FPGA-Computer/Linear-Power-Supply/README.md

These is my entry for the 1k Challenge for 2016
This is a linear power supply that is controlled digitally by a ATMega8.

The hardware design is licensed under a Creative Commons BY 4.0 International License.
The firmware is licensed under GPL 3.0

Schematic is EagleCAD file and firmware is for Atmel Studio 7.0.

The full detail of these licenses:

http://creativecommons.org/licenses/by/4.0/

http://www.gnu.org/licenses/gpl-3.0.en.html

Project page:
https://hw-by-design.blogspot.com/2018/07/adjustable-linear-bench-supply-in-1k.html
