FPGA-Computer/Linear-Power-Supply/Fuse setting.png

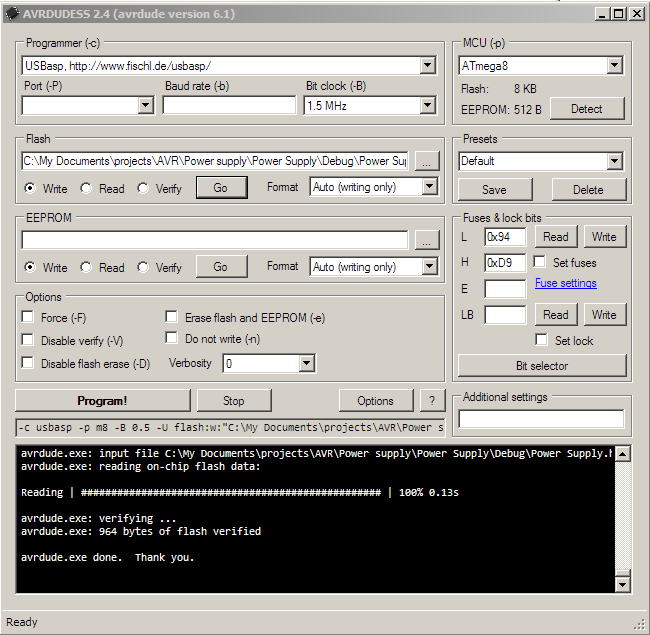
Fuse setting.png
