FPGA-Computer/Linear-Power-Supply/Program Size.png

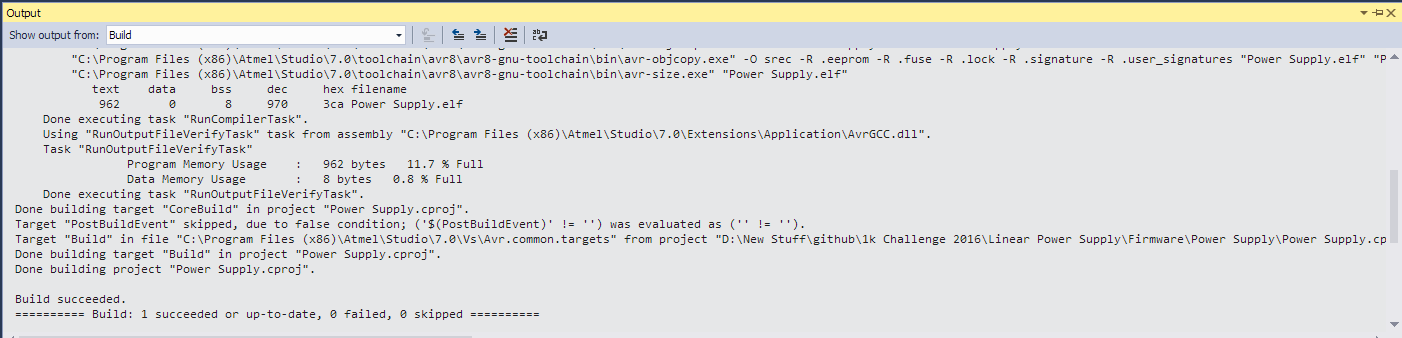
Program Size.png
