FPGA-Computer/Linear-Power-Supply/Hardware/Adj.pdf

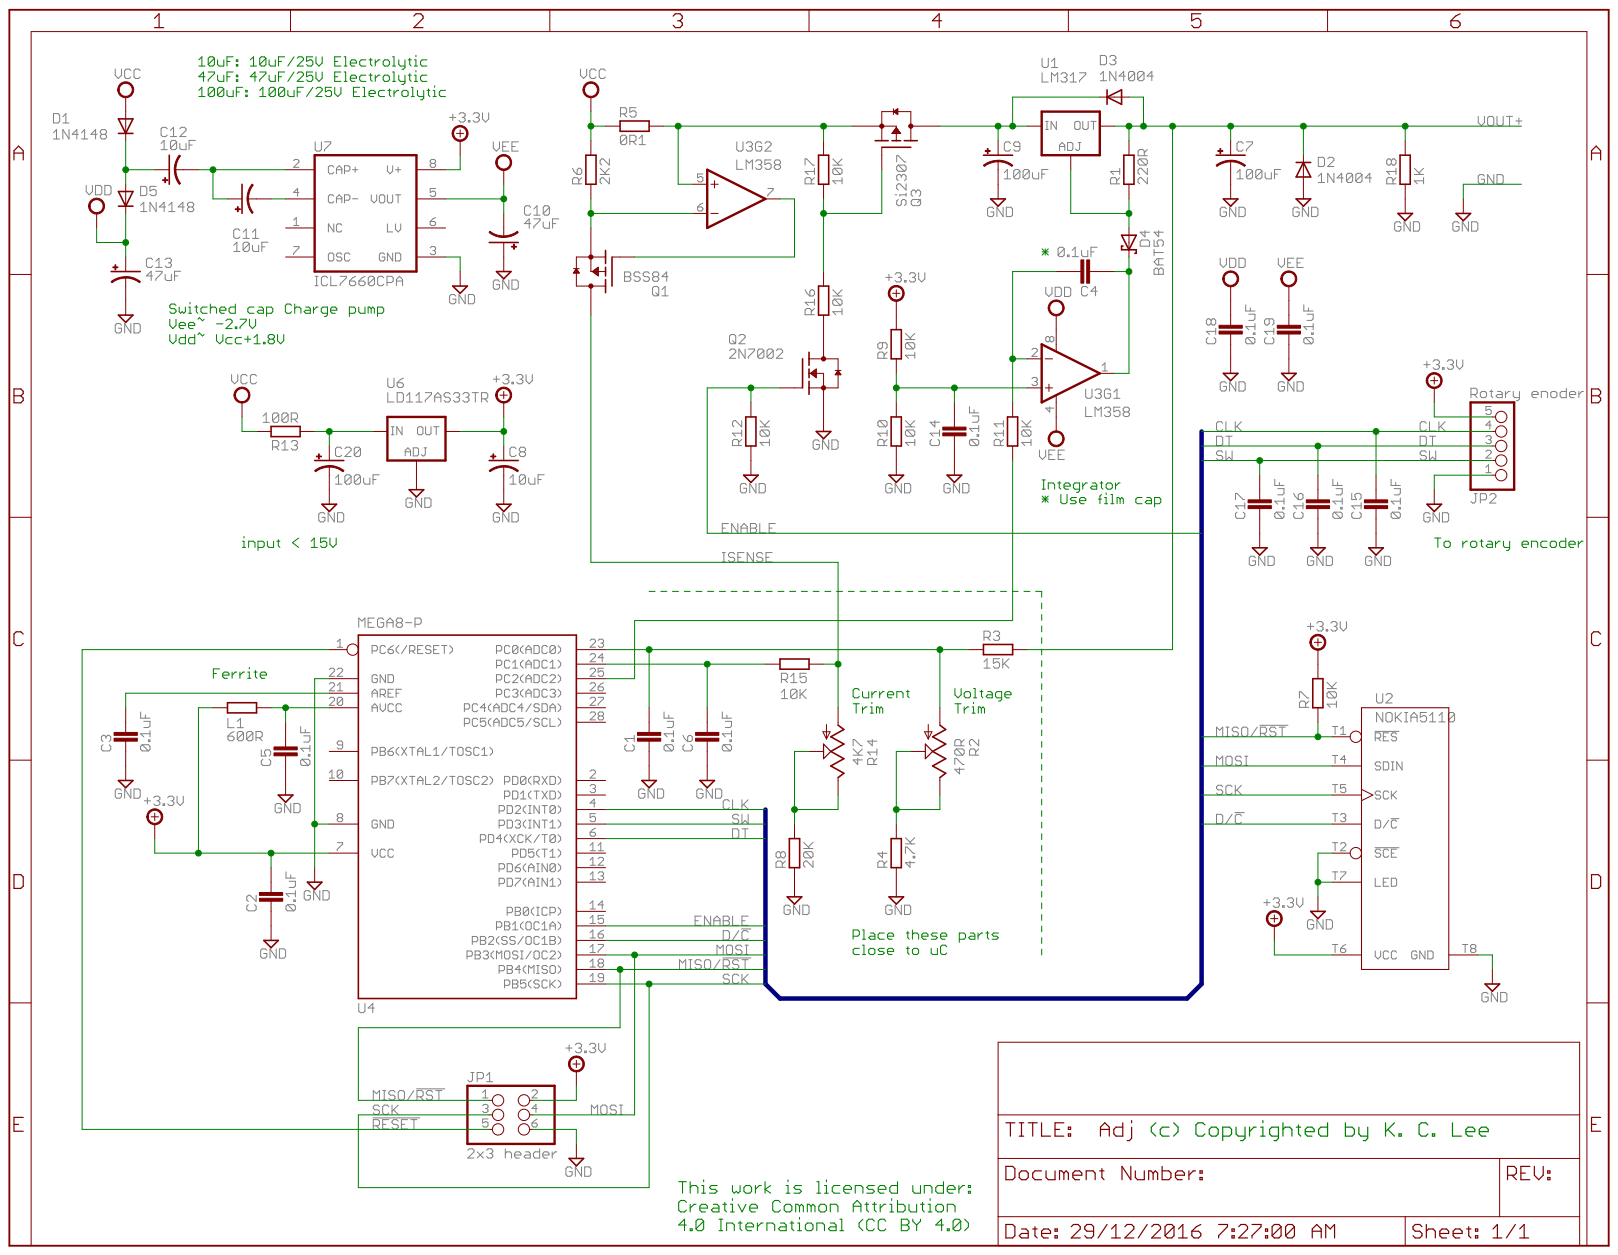
[picture p3: page 1]
