FPGA-Computer/Linear-Power-Supply/Hardware/LTSpice Simulations/adj linear regulator minus current sense.asc

C5: cap; 0.1µF
C6: polcap; 10µ; V=16 Irms=35m Rser=2.8 Lser=0 mfg="Nichicon" pn="UPR1C100MAH" type="Al electrolytic"
M2: pmos; BSS84
M3: nmos; 2N7002
R1: res; 220R
R2: res; 0.1R
R5: res; 10K
R6: res; 10K
R7: res; 10K
R8: res; 10R
U1: LT317A
U2: opamp2; ""
V1: voltage; 12V
V2: voltage; 3.3V
V3: voltage; PULSE(0 3.3V 100us 40ns 40ns 10ms 100ms)
V4: voltage; PULSE(0 3.3V 50ms 40ns 40ns 10ms 100ms)
V5: voltage; 2.5V
V6: voltage; 2V
Named nets: 0, Vout
.include "lm2904.lib"
.tran 250ms startup uic
