FPGA-Computer/Linear-Power-Supply/Hardware/LTSpice Simulations/adj linear regulator-1.asc

C1: cap; 1µ; V=16 Irms=3.55 Rser=0.0172 Lser=0 mfg="KEMET" pn="C1210C105K4PAC" type="X5R"
C5: cap; 0.1µF
C6: polcap; 10µ; V=25 Irms=39m Rser=2.8 Lser=0 mfg="Nichicon" pn="UPR1E100MAH" type="Al electrolytic"
D1: diode; 1N914
D2: diode; 1N914
M1: pmos; BSS84
M2: pmos; BSS84
M3: nmos; 2N7002
R1: res; 220R
R2: res; 0.1R
R3: res; 1K
R4: res; 20K
R5: res; 10K
R6: res; 10K
R7: res; 10K
R8: res; 10R
R9: res; 220K
U1: LT317A
U2: opamp2; ""
U4: opamp2; ""
V1: voltage; 12V
V2: voltage; 3.3V
V3: voltage; PULSE(0V 3.3V 50ms 6ns 6ns 10ms 100ms)
V4: voltage; PULSE(0 3.3V  100ms 6ns 6ns 10ms 100ms)
V5: voltage; 2.5V
V6: voltage; 2V
Named nets: 0, Vout, Isense
.include "lm2904.lib"
.tran 250ms startup uic
