FPGA-Computer/Linear-Power-Supply/Hardware/LTSpice Simulations/adj linear regulator-2.asc

C1: polcap; 100µ; V=25 Irms=145m Rser=0.62 Lser=0 mfg="Nichicon" pn="UPR1E101MPH" type="Al electrolytic"
C2: polcap; 100µ; V=25 Irms=145m Rser=0.62 Lser=0 mfg="Nichicon" pn="UPR1E101MPH" type="Al electrolytic"
C5: cap; 0.1µF
D1: schottky; MBRS140
M1: pmos; BSS84
M2: pmos; BSS84
M3: nmos; 2N7002
M4: pmos; FDC5614P
M5: nmos; 2N7002
R1: res; 220R
R2: res; 0.1R
R3: res; 2K2
R4: res; 11K
R5: res; 10K
R6: res; 10K
R7: res; 10K
R8: res; 1K
R9: res; 10K
R10: res; 10K
U1: LT317A
U2: opamp2; ""
U4: opamp2; ""
V1: voltage; 12V
V2: voltage; 3.3V
V3: voltage; PULSE(0 3.3V 100us 40ns 40ns 10ms 100ms)
V4: voltage; PULSE(0 3.3V 50ms 40ns 40ns 10ms 100ms)
V5: voltage; 2.5V
V6: voltage; 2V
V7: voltage; PULSE(0 3.3V 15ms 40ns 40ns 1000ms)
Named nets: 0, Vout, Isense
.include "lm2904.lib"
.tran 250ms startup uic
