FPGA-Computer/Linear-Power-Supply/Hardware/LTSpice Simulations/High side current sense.asc

C6: polcap; 10µ; V=16 Irms=35m Rser=2.8 Lser=0 mfg="Nichicon" pn="UPR1C100MAH" type="Al electrolytic"
M1: pmos; BSS84
R1: res; 220R
R2: res; 0.1R
R3: res; 1K
R4: res; 20K
R8: res; 10R
U1: LT317A
U4: opamp2; ""
V1: voltage; 12V
V5: voltage; 2.5V
V6: voltage; 2V
Named nets: 0, Vout, Isense
.include "lm2904.lib"
.tran 250ms startup uic
