FPGA-Computer/Linear-Power-Supply/Hardware/Adj.sch

## EAGLE design Hardware/Adj.sch (2016-12-29)

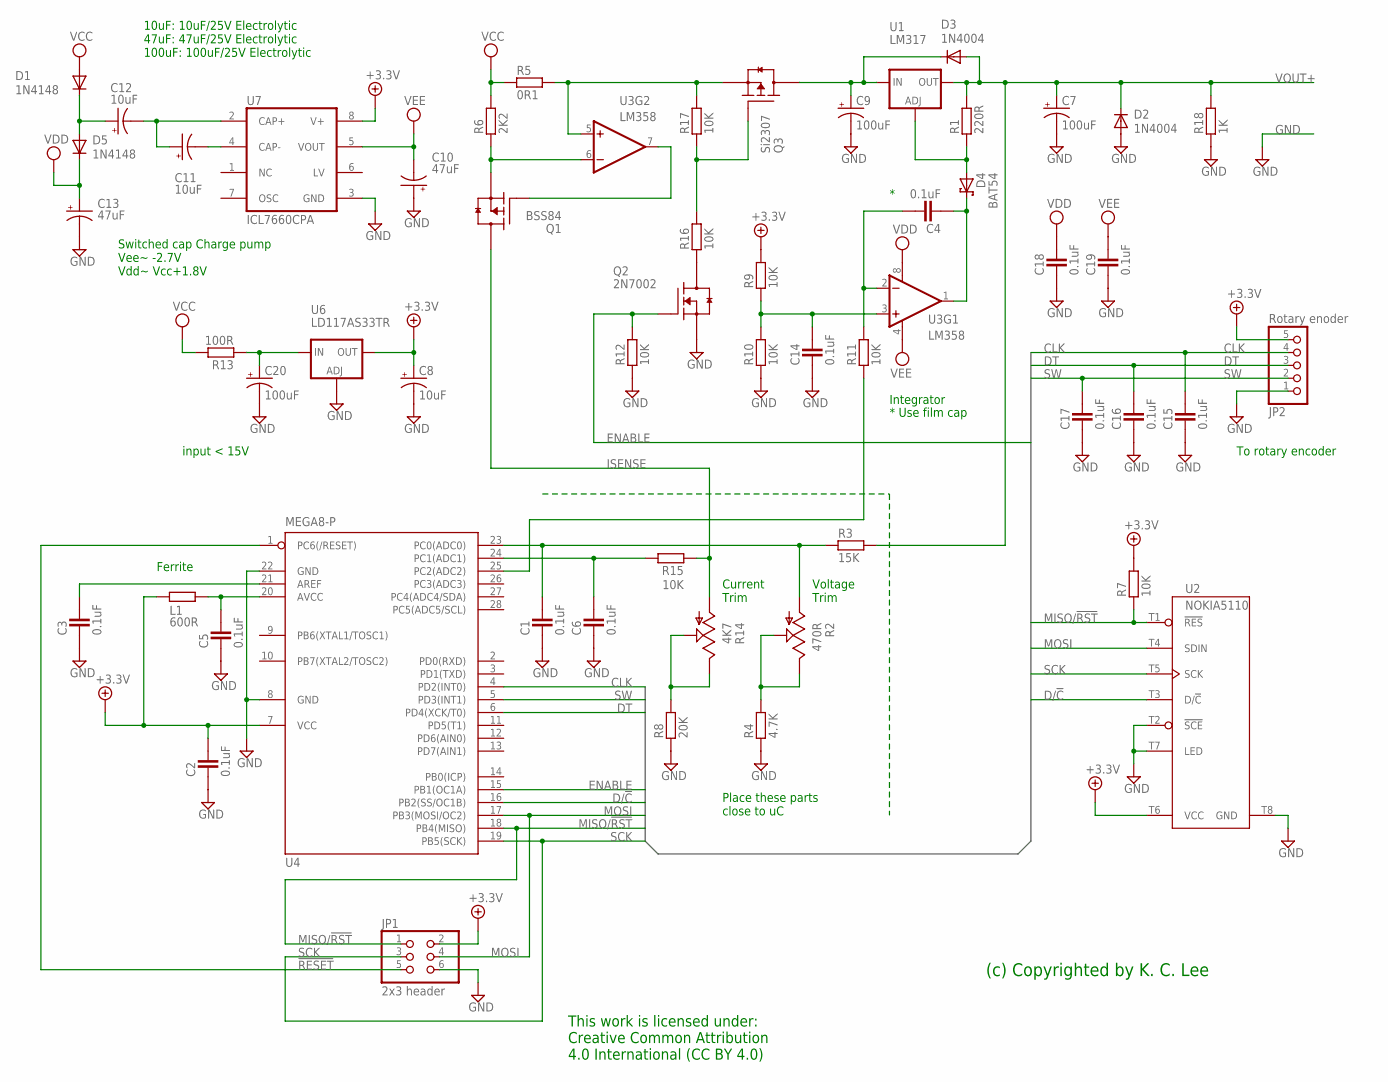
[picture p4: schematic Adj.sch]

Parts:
C1, C2, C3, C4, C5, C6, C14, C15, C16, C17, C18, C19: 0.1uF; CAPC2012X145AN; PARTNO *
C7, C9, C20: 100uF; E2,5-6E; PARTNO 100uF/25V
C8, C11, C12: 10uF; E2,5-6E; PARTNO 10uF/25V
C10, C13: 47uF; E2,5-6E; PARTNO 47uF/25V
D1, D5: 1N4148; DO35-7; PARTNO *
D2, D3: 1N4004; DO41-10; PARTNO *
D4: BAT54; SOT95P280X135-3N; PARTNO *
JP1: 2x3 header; 2X03; PARTNO *
JP2: Rotary enoder; 1X05; PARTNO *
L1: 600R; RESC1608X55N; PARTNO Ferrite 600R@100MHz
Q1: BSS84; SOT95P280X135-3N; PARTNO *
Q2: 2N7002; SOT95P280X135-3N; PARTNO *
Q3: Si2307; SOT95P280X135-3N; PARTNO *
R1: 220R; RESC1608X55N; PARTNO *
R2: 470R; B25U; PARTNO *
R3: 15K; RESC1608X55N; PARTNO *
R4: 4.7K; RESC1608X55N; PARTNO *
R5: 0R1; RESC1608X55N; PARTNO 0R1 1W
R6: 2K2; RESC1608X55N; PARTNO *
R7, R9, R10, R11, R12, R15, R16, R17: 10K; RESC1608X55N; PARTNO *
R8: 20K; RESC1608X55N; PARTNO *
R13: 100R; RESC1608X55N; PARTNO *
R14: 4K7; B25U; PARTNO *
R18: 1K; RESC1608X55N; PARTNO *
U1: LM317; TO220-ADJ; PARTNO *
U2: NOKIA5110; NOKIA5110-ALT-TOP; PARTNO Nokia 5110 LCD
U3: LM358; DIP08; PARTNO *
U4: MEGA8-P; DIL28-3; PARTNO ATMerga8A
U6: LD117AS33TR; SOT223; PARTNO *
U7: ICL7660CPA; DIL08; PARTNO ICL7660CPA

Connections:
!RESET: JP1.5, U4.1 (PC6(/RESET))
+3.3V: C2.2, C8.+, JP1.2, JP2.5, L1.1, R7.2, R9.2, U2.T6 (VCC), U4.7 (VCC), U6.2 (OUT), U7.8 (V+)
CLK: C15.2, JP2.4, U4.4 (PD2(INT0))
D/!C: U2.T3 (D/!C), U4.16 (PB2(SS/OC1B))
DT: C16.2, JP2.3, U4.6 (PD4(XCK/T0))
ENABLE: Q2.1 (G), R12.2, U4.15 (PB1(OC1A))
GND: C1.1, C2.1, C3.1, C5.1, C6.1, C7.-, C8.-, C9.-, C10.+, C13.-, C14.1, C15.1, C16.1, C17.1, C18.1, C19.1, C20.-, D2.A, JP1.6, JP2.1, Q2.2 (S), R4.1, R8.1, R10.1, R12.1, R18.1, U2.T2 (!SCE), U2.T7 (LED), U2.T8 (GND), U4.8 (GND), U4.22 (GND), U6.1 (ADJ), U7.3 (GND)
ISENSE: Q1.3 (D), R14.A, R15.1
MISO/!RST: JP1.1, R7.1, U2.T1 (!RES), U4.18 (PB4(MISO))
MOSI: JP1.4, U2.T4 (SDIN), U4.17 (PB3(MOSI/OC2))
unnamed: C5.2, L1.2, U4.20 (AVCC)
unnamed: C4.1, D4.3 (K), U3.1 (OUT)
unnamed: C20.+, R13.1, U6.3 (IN)
unnamed: R2.E, R2.S, R4.2
unnamed: C1.2, R2.A, R3.1, U4.23 (PC0(ADC0))
unnamed: C4.2, R11.2, U3.2 (-IN)
unnamed: C9.+, D3.C, Q3.3 (D), U1.IN
unnamed: Q1.2 (S), R6.1, U3.6 (-IN)
unnamed: C3.2, U4.21 (AREF)
unnamed: C6.2, R15.2, U4.24 (PC1(ADC1))
unnamed: C11.-, U7.4 (CAP-)
unnamed: C11.+, C12.-, U7.2 (CAP+)
unnamed: C12.+, D1.C, D5.A
unnamed: Q1.1 (G), U3.7 (OUT)
unnamed: C14.2, R9.1, R10.2, U3.3 (+IN)
unnamed: R11.1, U4.25 (PC2(ADC2))
unnamed: Q3.2 (S), R5.2, R17.2, U3.5 (+IN)
unnamed: R8.2, R14.E, R14.S
unnamed: Q2.3 (D), R16.1
unnamed: Q3.1 (G), R16.2, R17.1
unnamed: D4.1 (A), R1.1, U1.ADJ
SCK: JP1.3, U2.T5 (SCK), U4.19 (PB5(SCK))
SW: C17.2, JP2.2, U4.5 (PD3(INT1))
VCC: D1.A, R5.1, R6.2, R13.2
VDD: C13.+, C18.2, D5.C, U3.8 (V+)
VEE: C10.-, C19.2, U3.4 (V-), U7.5 (VOUT)
VOUT+: C7.+, D2.C, D3.A, R1.2, R3.2, R18.2, U1.OUT

Notes on the sheet:
To rotary encoder
10uF: 10uF/25V Electrolytic 47uF: 47uF/25V Electrolytic 100uF: 100uF/25V Electrolytic
Switched cap Charge pump Vee~ -2.7V Vdd~ Vcc+1.8V
input < 15V
Voltage Trim
Place these parts close to uC
* Use film cap
Integrator
Current Trim
This work is licensed under: Creative Common Attribution 4.0 International (CC BY 4.0)
(c) Copyrighted by K. C. Lee
Ferrite
