FPGA-Computer/Linear-Power-Supply/(commit log)

2016-12-29 update 1
    [Adj.sch]
2016-12-29 clean u 1
    [Adj BOM.csv, Adj.sch]
